trgzng1802/AC-POWER-MEASURING-STM32/Report/Source/images/thucte.jpg

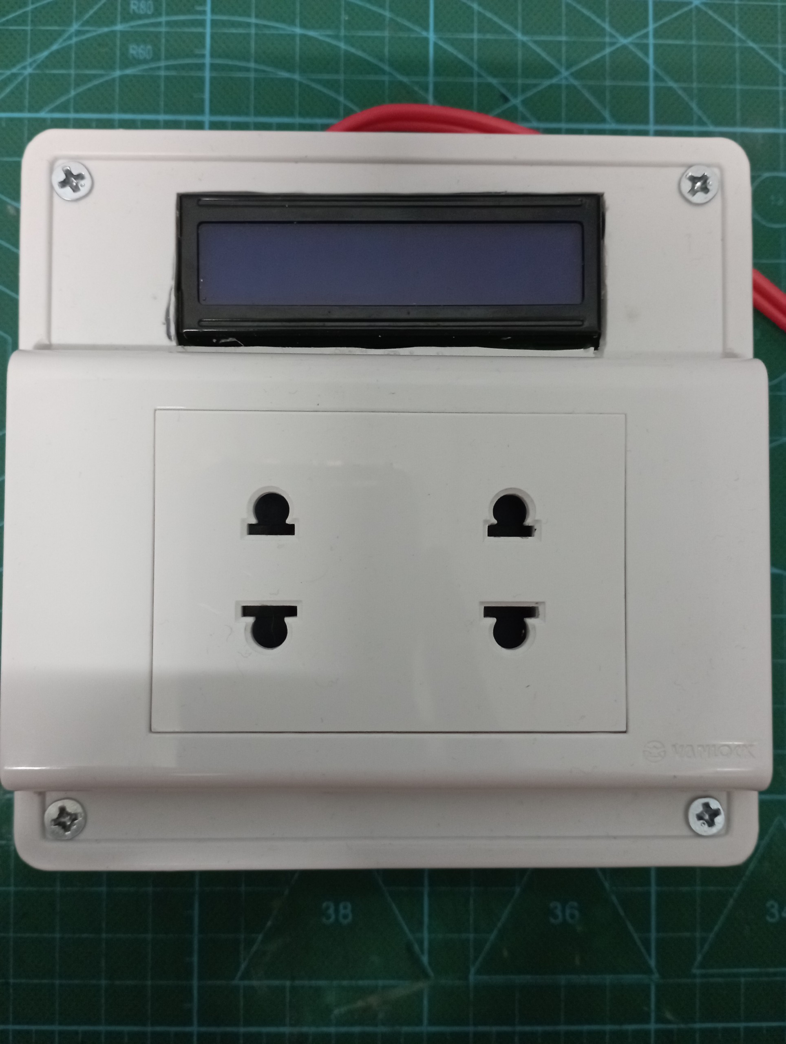
Report/Source/images/thucte.jpg
