trgzng1802/AC-POWER-MEASURING-STM32/Report/Source/images/bien_ap_thuong.jpg

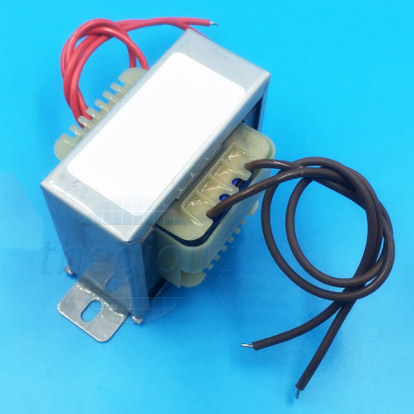
Report/Source/images/bien_ap_thuong.jpg
