trgzng1802/AC-POWER-MEASURING-STM32/SCRIPT/Power-Supplies.docx

NGUỒN CÁCH LY VÀ NGUỒN KHÔNG CÁCH LY

Nguồn cách ly

Nguồn cách ly là nguồn cách ly về điện với phần mà nó đang cấp nguồn, thường là bởi biến áp cách ly. Đồng nghĩa với việc nguồn điện được truyền từ đầu vào đến đầu ra mà không cần kết nối trực tiếp giữa 2 phần.
