trgzng1802/AC-POWER-MEASURING-STM32/Report/Source/images/adc_scan_continuous.png

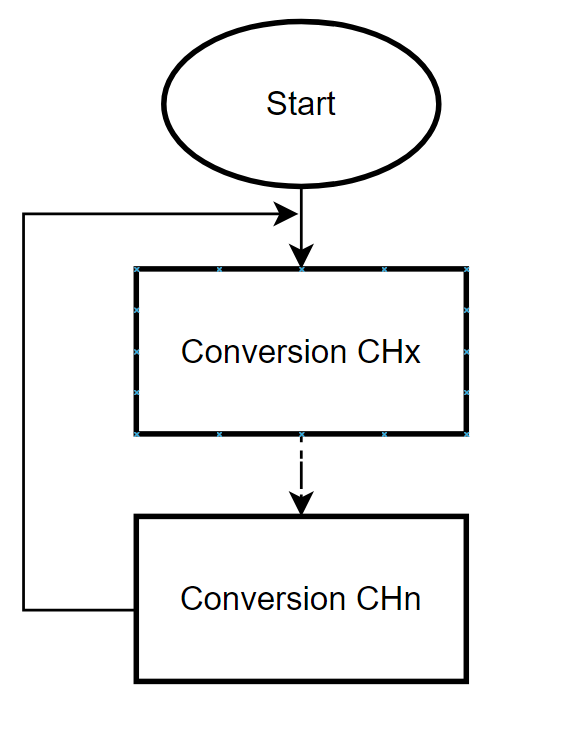
Report/Source/images/adc_scan_continuous.png
