trgzng1802/AC-POWER-MEASURING-STM32/Report/Source/images/adc_scan_single_mode.png

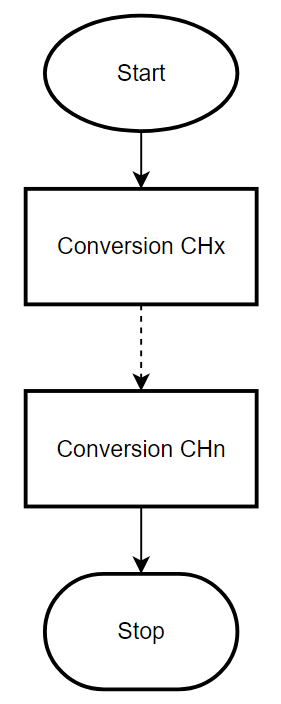
Report/Source/images/adc_scan_single_mode.png
