trgzng1802/AC-POWER-MEASURING-STM32/Report/Source/images/adc_single_single_conv.png

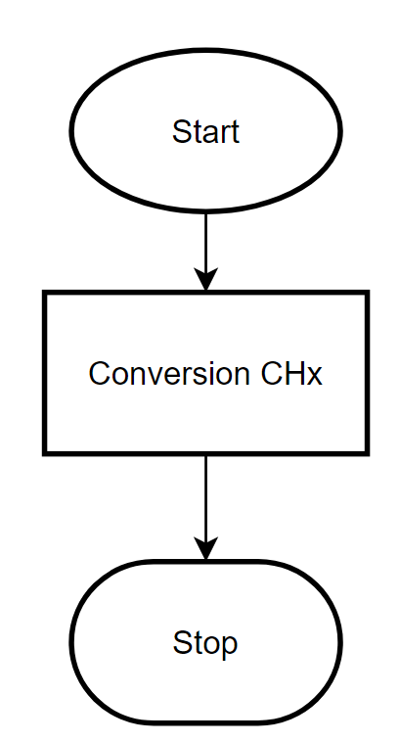
Report/Source/images/adc_single_single_conv.png
