trgzng1802/AC-POWER-MEASURING-STM32/Report/Source/images/clock_tree.png

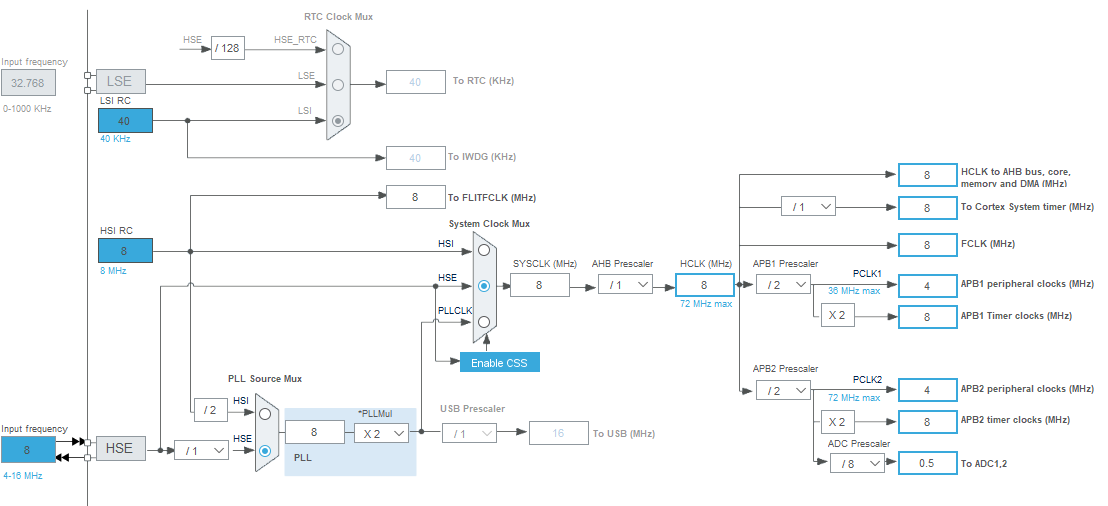
Report/Source/images/clock_tree.png
