trgzng1802/AC-POWER-MEASURING-STM32/Report/Source/images/config_adc.png

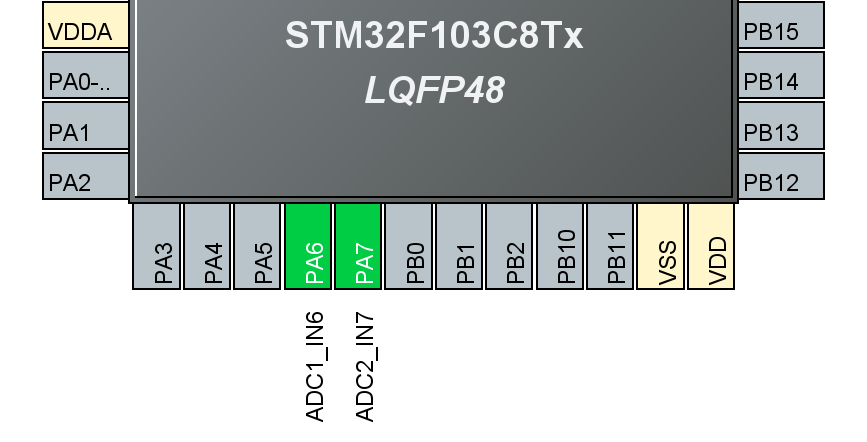
Report/Source/images/config_adc.png
