trgzng1802/AC-POWER-MEASURING-STM32/Report/Source/images/current_meas.png

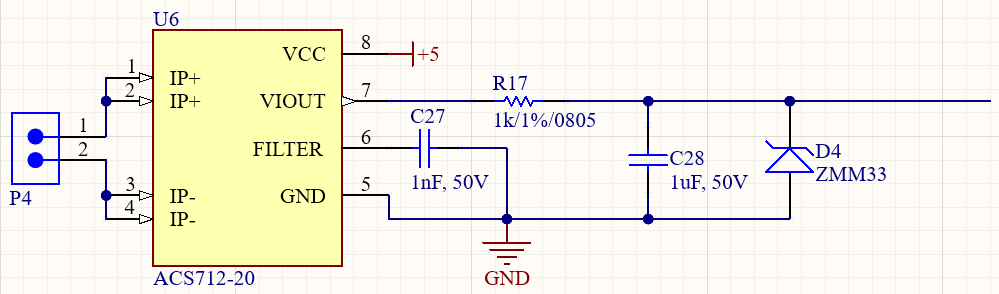
Report/Source/images/current_meas.png
