trgzng1802/AC-POWER-MEASURING-STM32/Report/Source/images/LDO_3.3.png

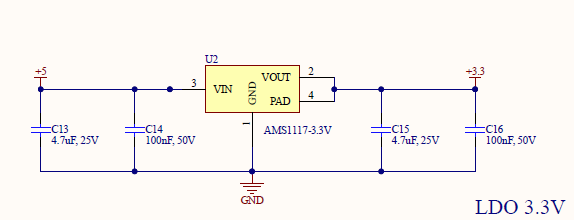
Report/Source/images/LDO_3.3.png
