trgzng1802/AC-POWER-MEASURING-STM32/Report/Source/images/LDO_5.png

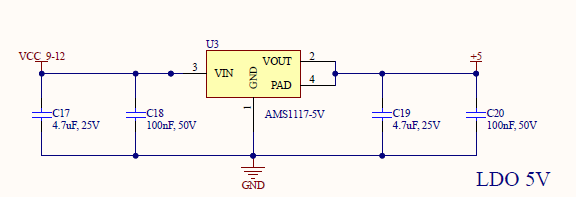
Report/Source/images/LDO_5.png
