trgzng1802/AC-POWER-MEASURING-STM32/Report/Source/images/opamp_diff_g20.png

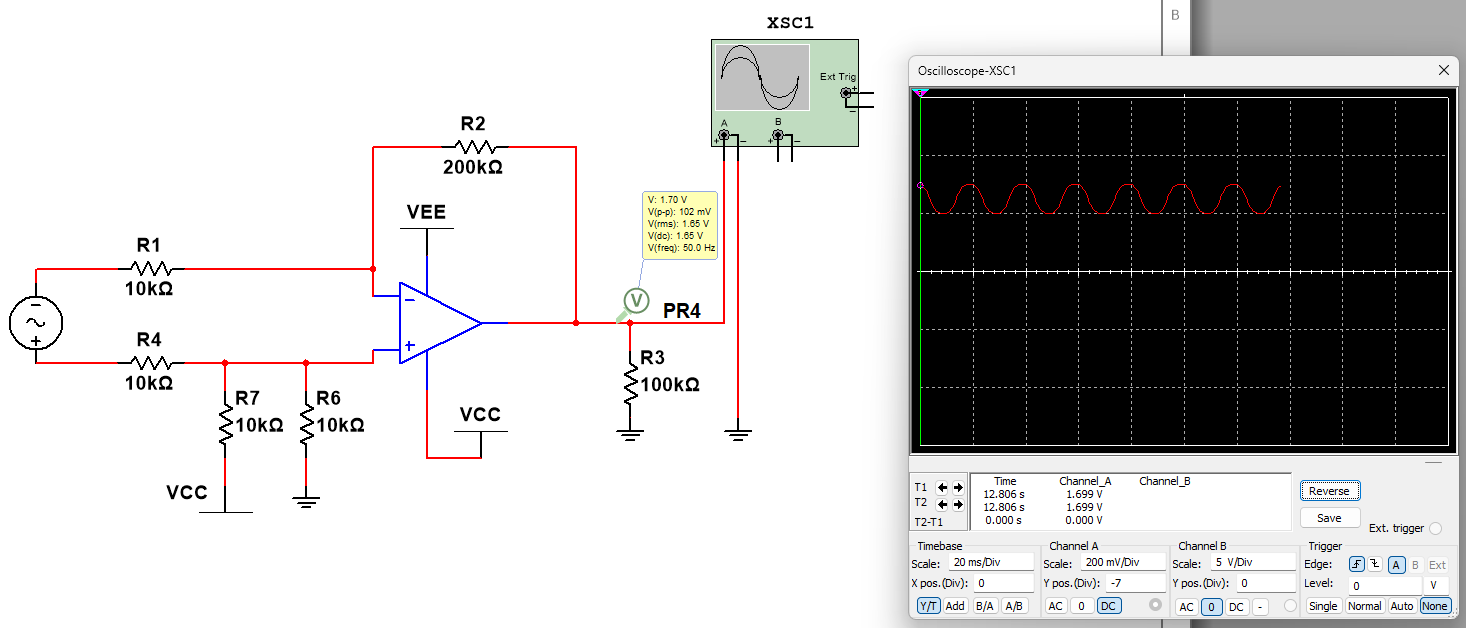
Report/Source/images/opamp_diff_g20.png
