trgzng1802/AC-POWER-MEASURING-STM32/Report/Source/images/opamp_differ.png

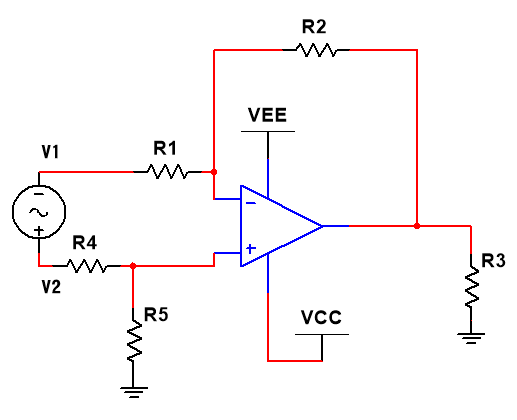
Report/Source/images/opamp_differ.png
