trgzng1802/AC-POWER-MEASURING-STM32/Report/Source/images/opamp_differ_simu.png

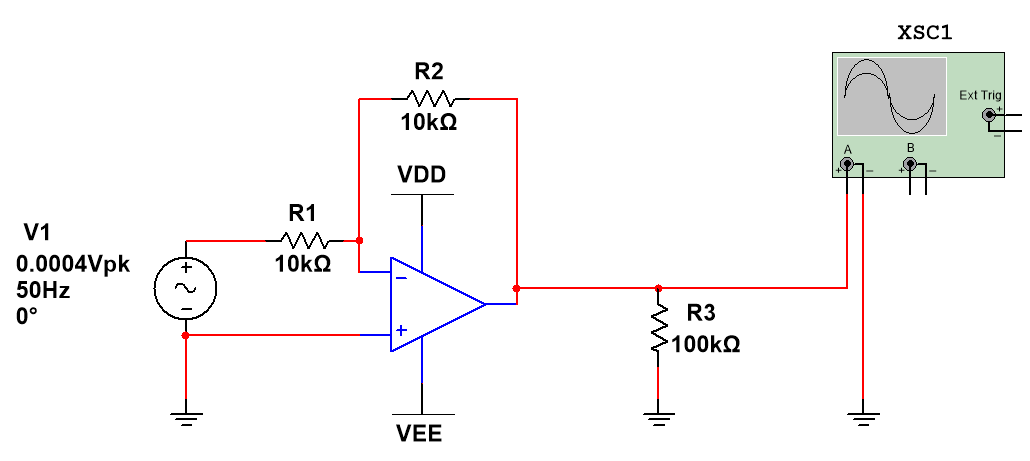
Report/Source/images/opamp_differ_simu.png
