trgzng1802/AC-POWER-MEASURING-STM32/Report/Source/images/xtal.png

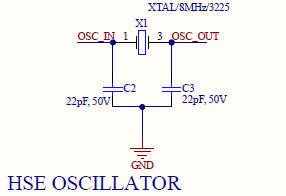
Report/Source/images/xtal.png
