trgzng1802/AC-POWER-MEASURING-STM32/SCRIPT/zmct103c_module_schematic.webp

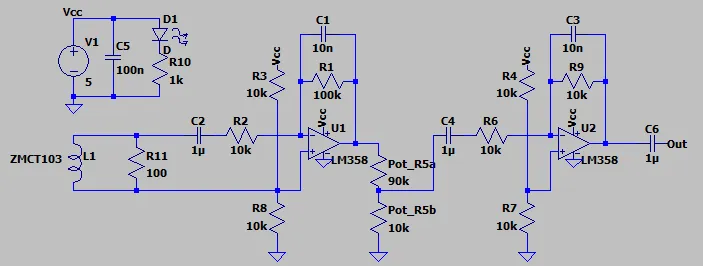
SCRIPT/zmct103c_module_schematic.webp
