trgzng1802/AC-POWER-MEASURING-STM32/HARDWARE/BOARD/AC_POWER_MEASURING/Project Outputs for AC_POWER_MEASURING/DOCs/2023-05-31_11-16_AC_POWER_MEASURING_SCHEMATICS.PDF

3 6 | 3 5
4 8 | 4 7


NEGA 2


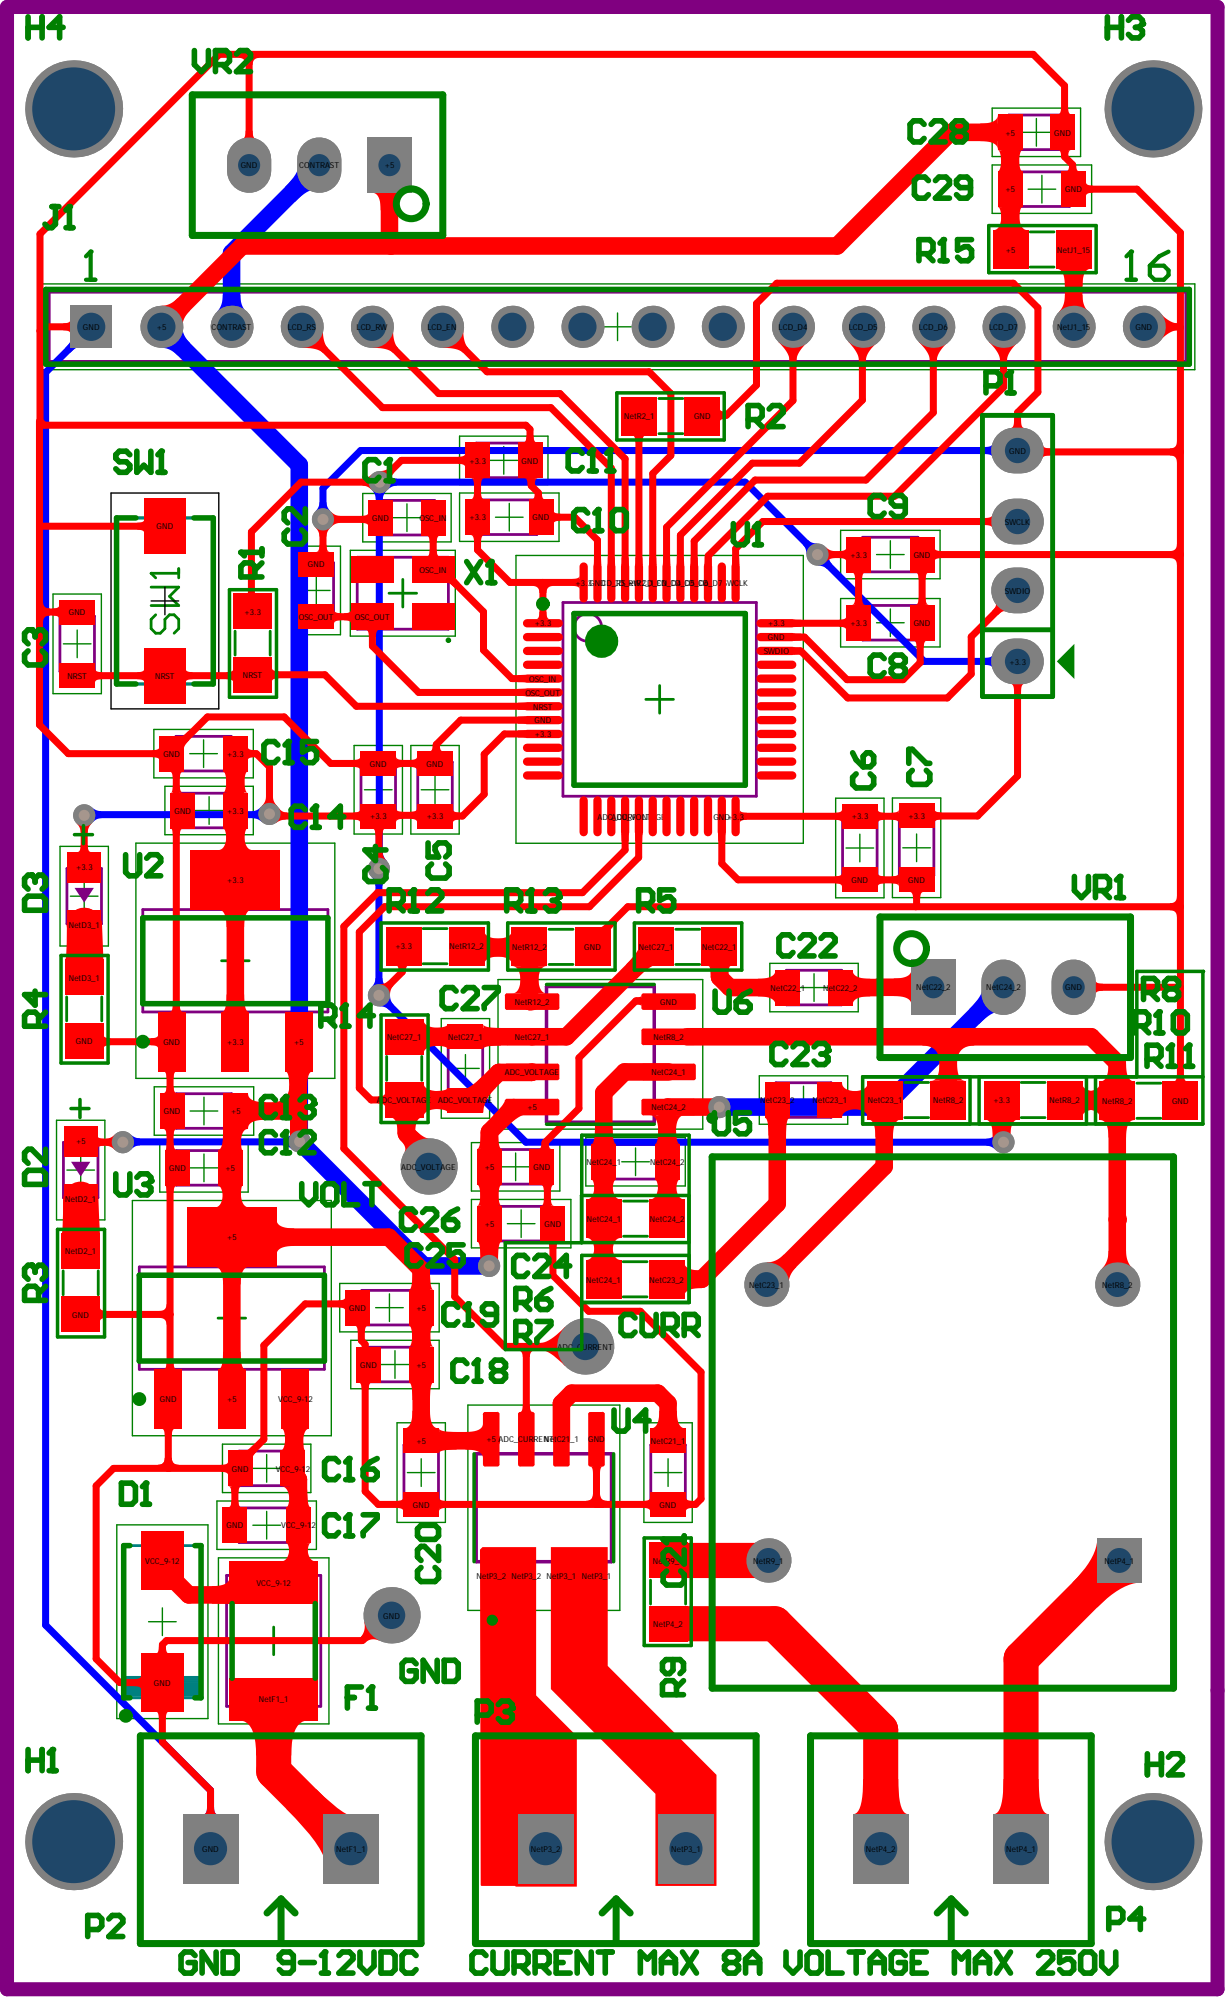
[picture p69: page 7]

NetC22_1 | NetC22_2

GND

+5 ADC_CURRENTetC21_1 GND

GND | VCC_9-12

GND | NetF1_1
