trgzng1802/AC-POWER-MEASURING-STM32/HARDWARE/BOARD/demo_1.pdf

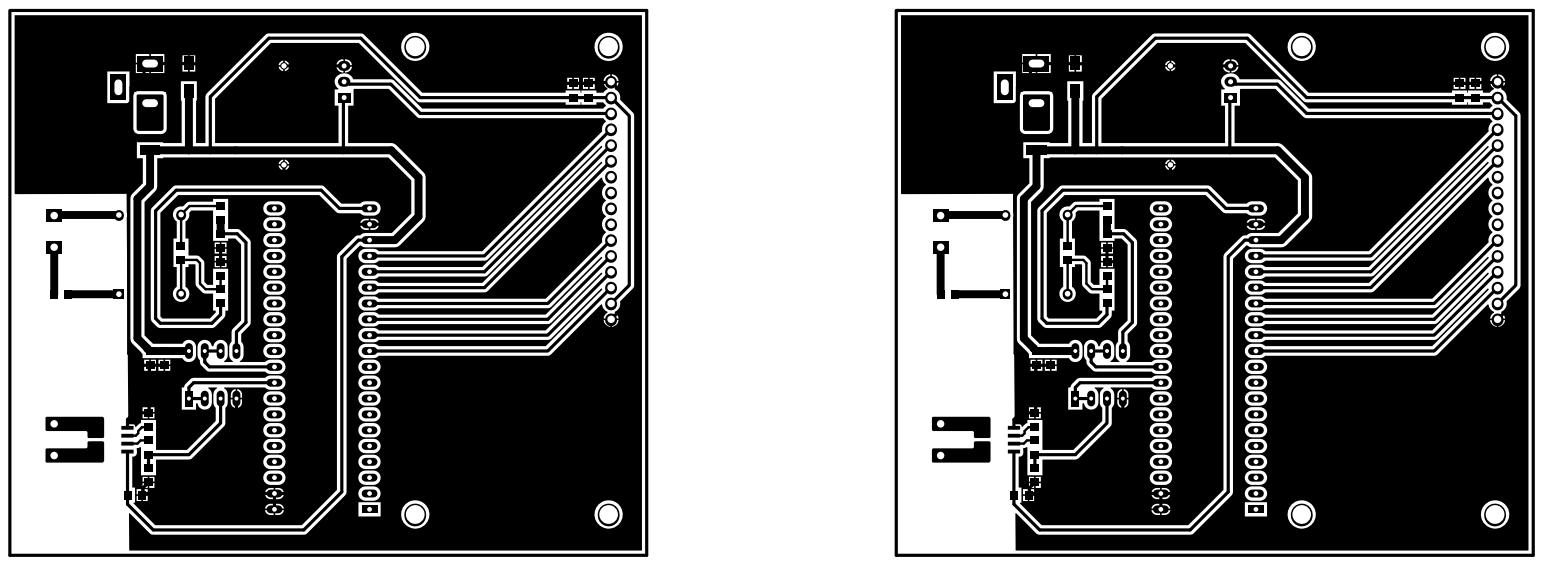
[picture p74: page 1]
