trgzng1802/AC-POWER-MEASURING-STM32/HARDWARE/BOARD/test_measure_v1.pdf

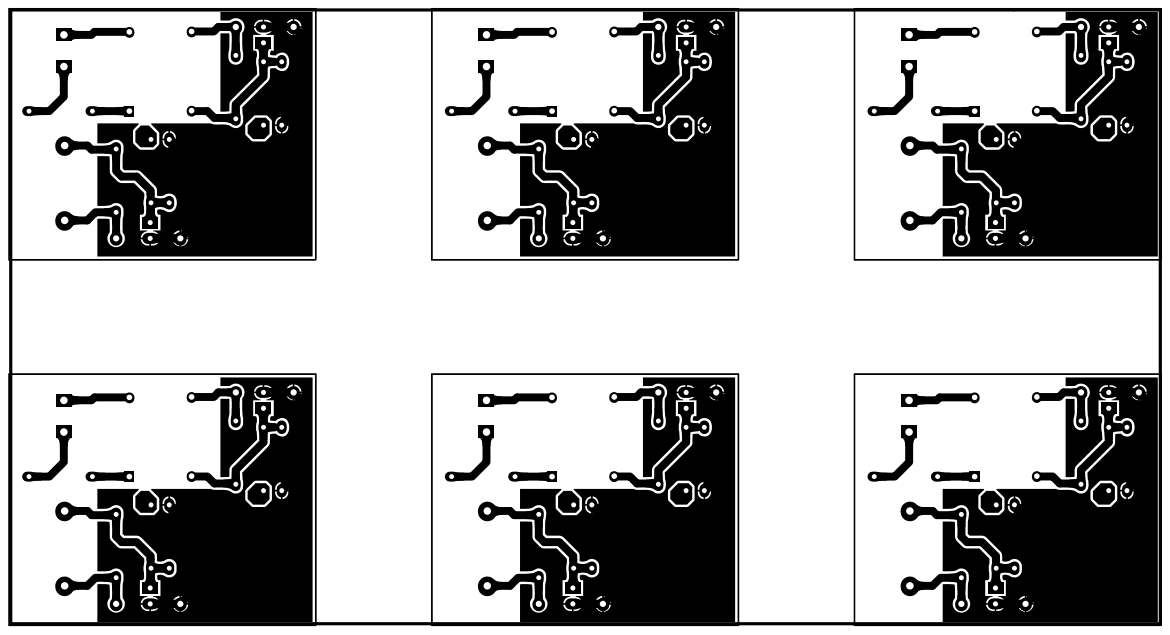
[picture p75: page 1]
