trgzng1802/AC-POWER-MEASURING-STM32/HARDWARE/BOARD/AC_POWER_MEASURING/Project Outputs for AC_POWER_MEASURING/ver1.PDF

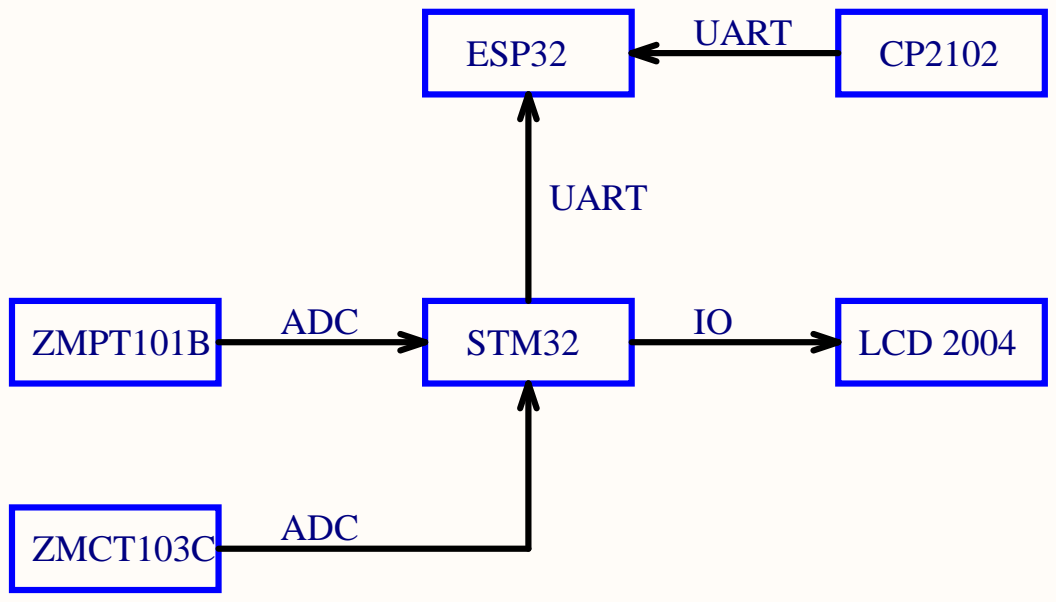
[picture p76: page 1]

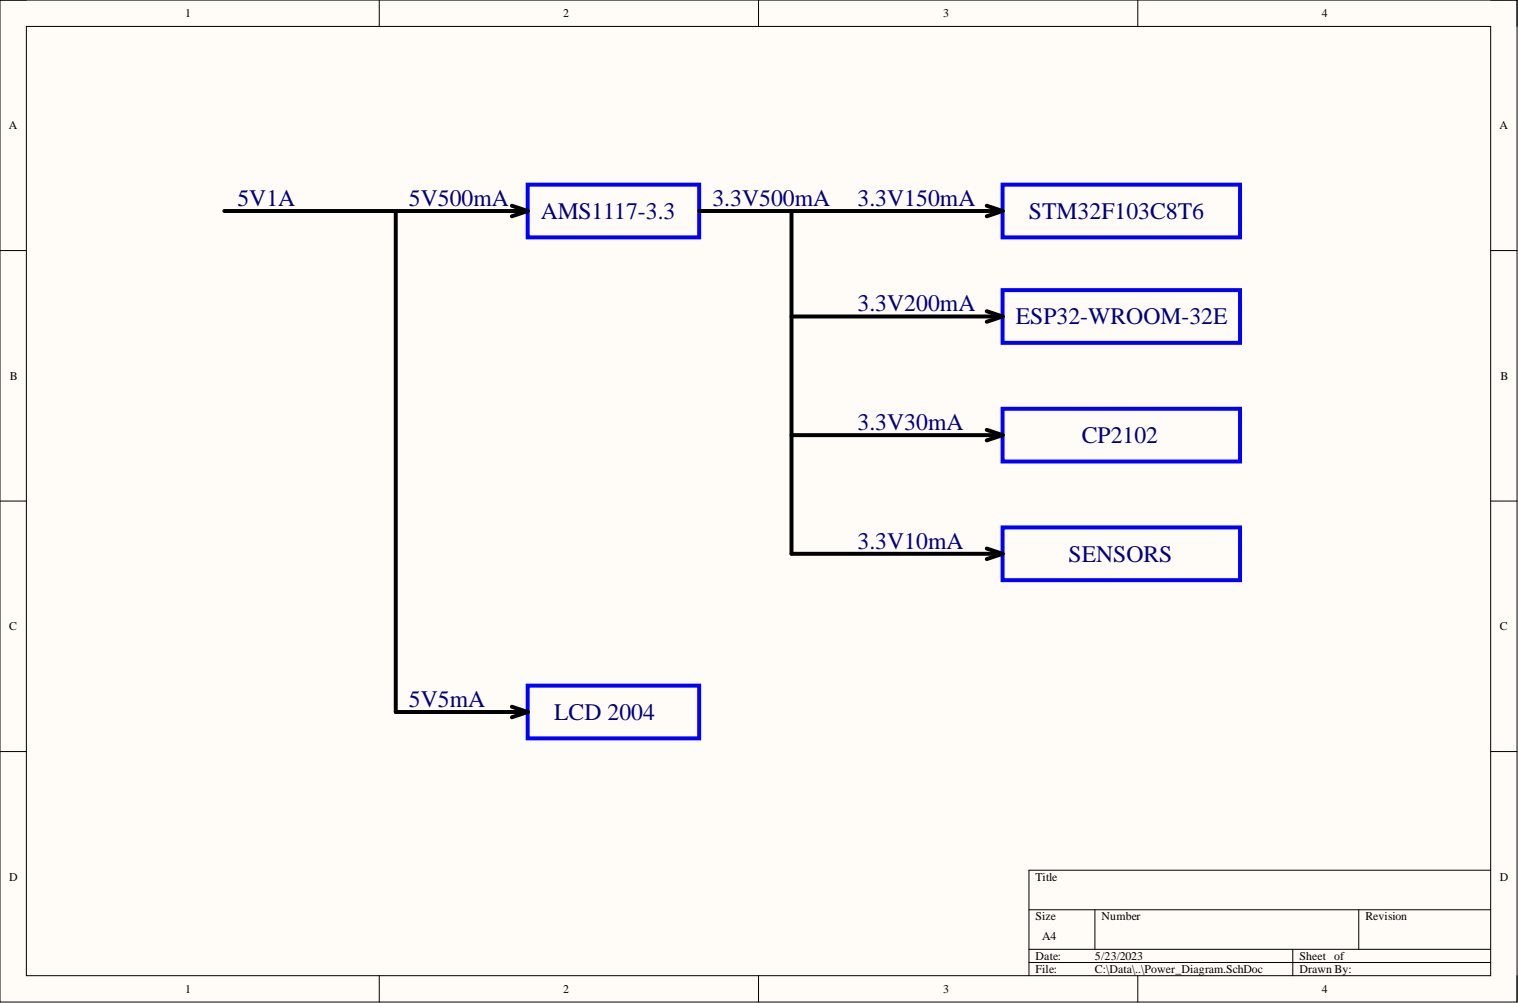
[picture p77: page 2]

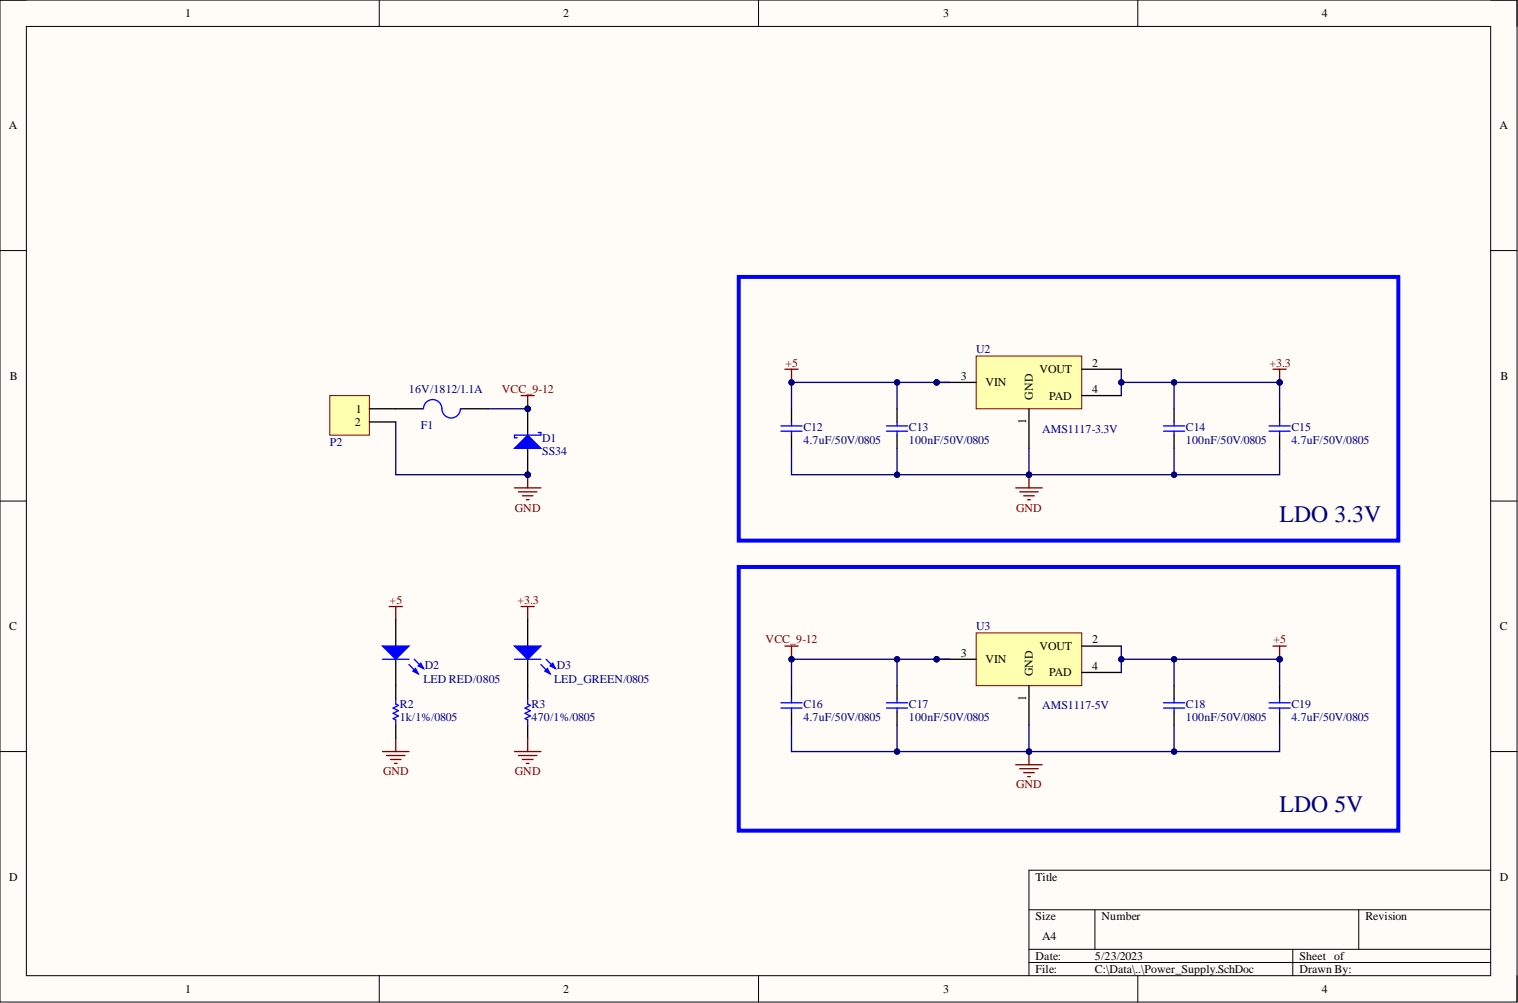
[picture p78: page 3]

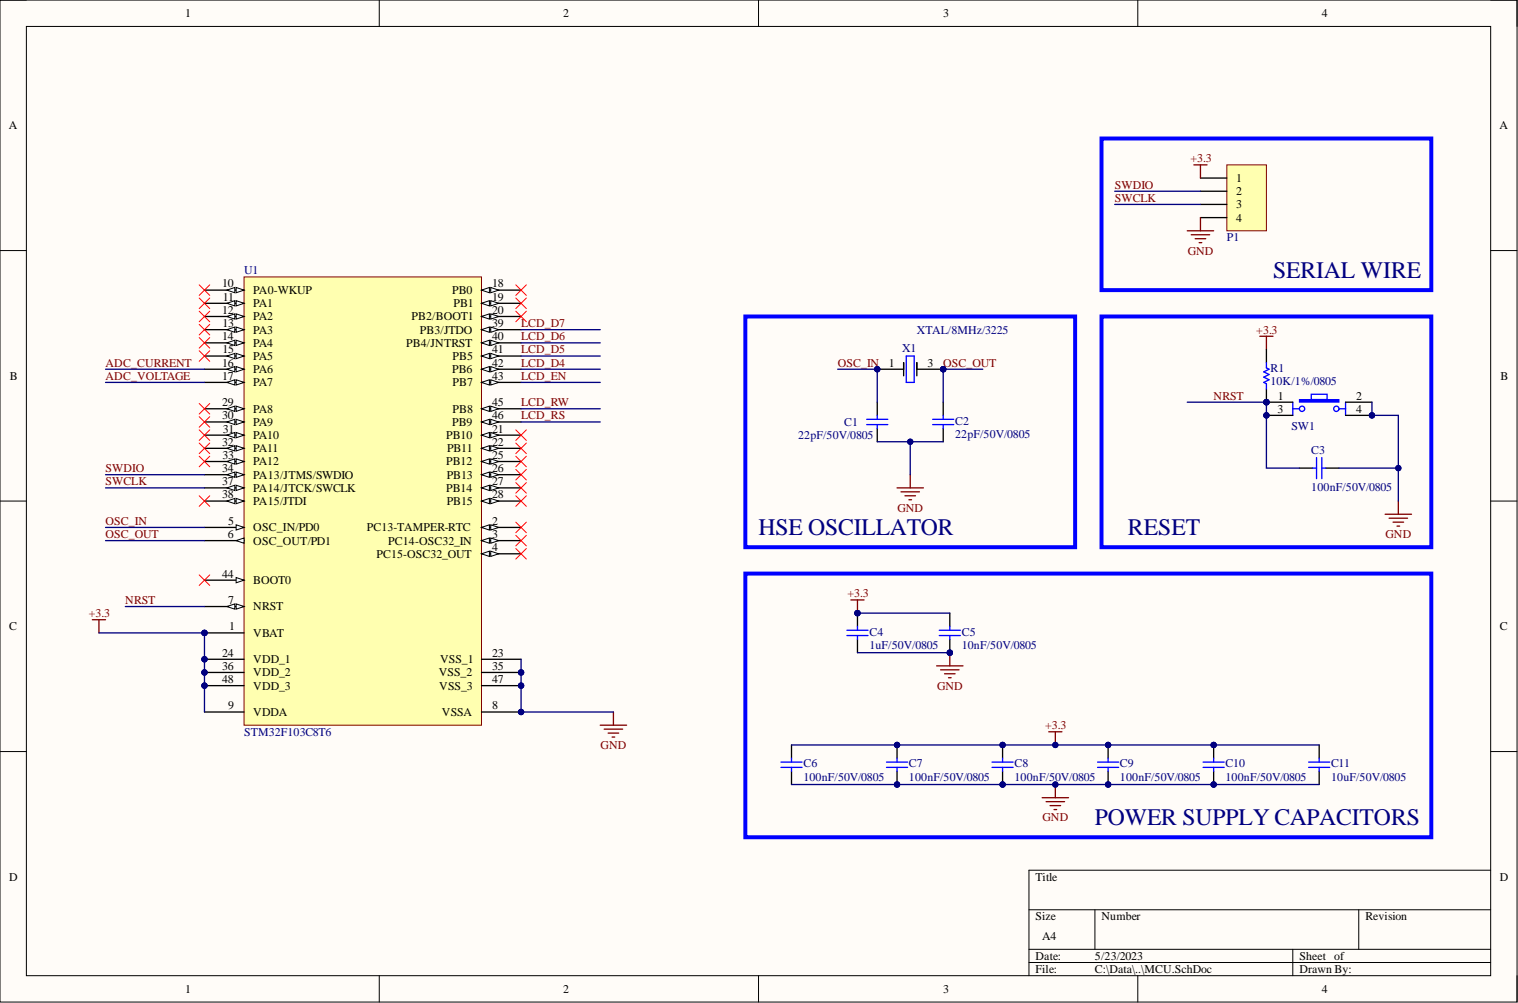
[picture p79: page 4]

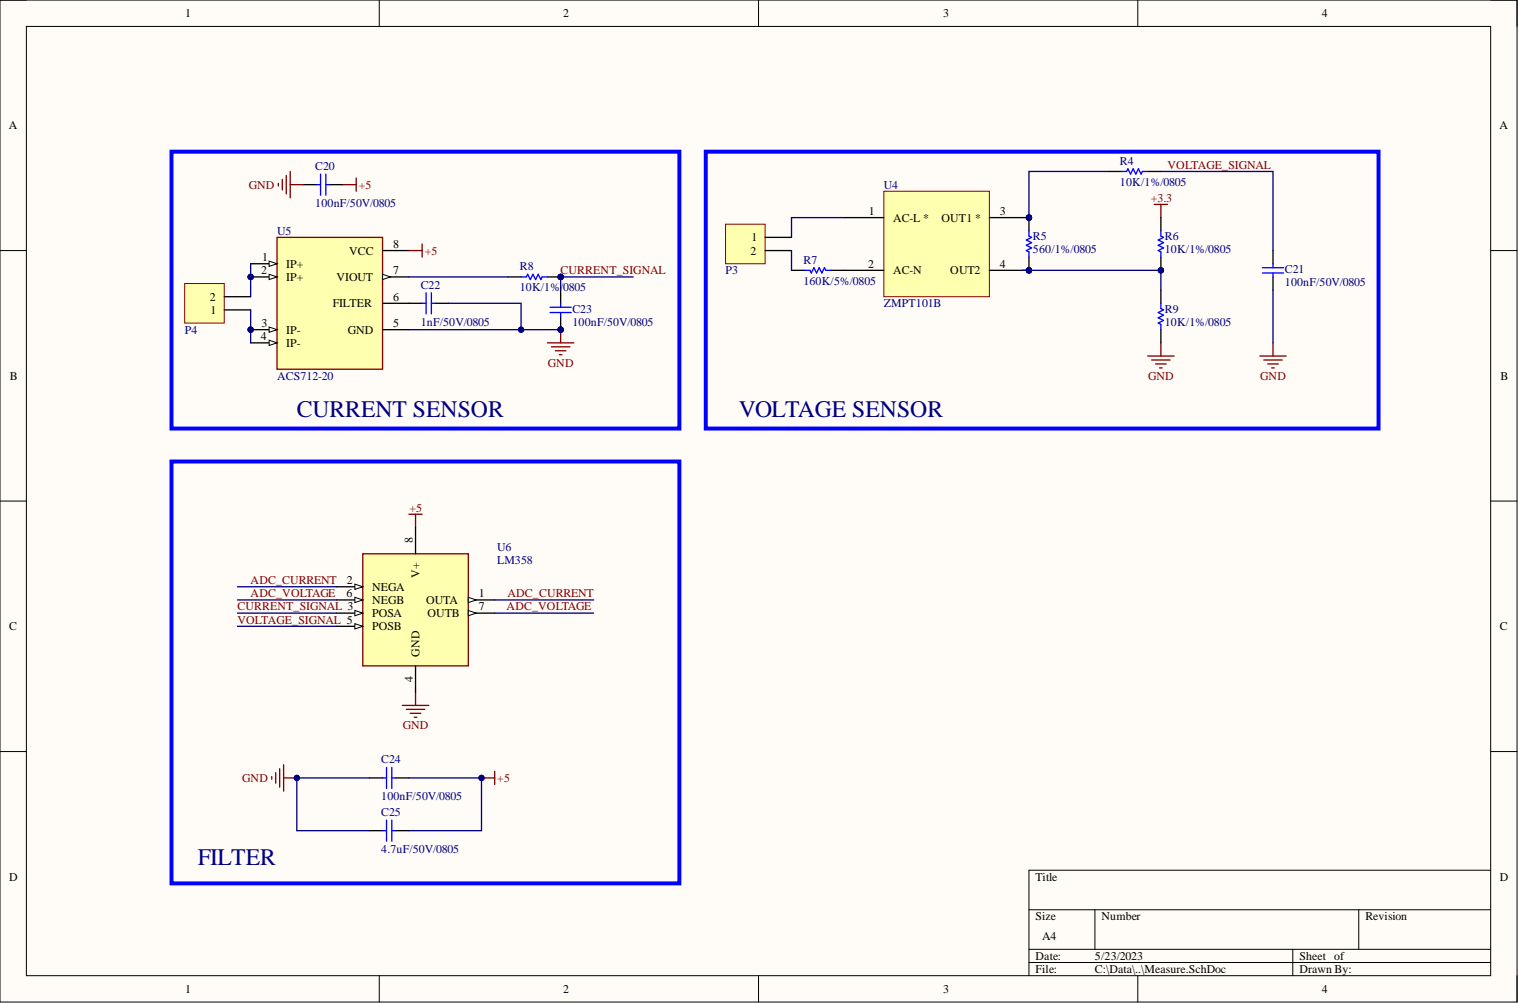
[picture p80: page 5]

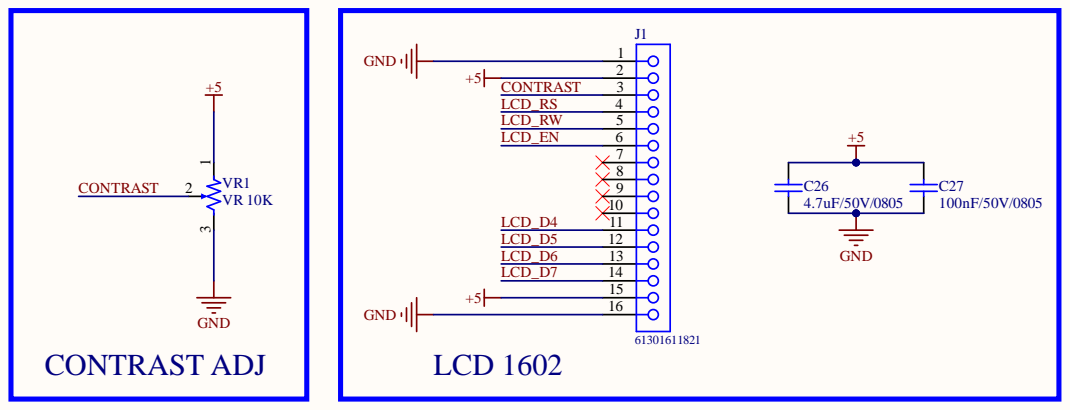
[picture p81: page 6]
