trgzng1802/AC-POWER-MEASURING-STM32/HARDWARE/BOARD/AC_POWER_MEASURING/Project Outputs for AC_POWER_MEASURING/DOCs/2023-05-24_17-29_AC_POWER_MEASURING_SCHEMATICS.PDF

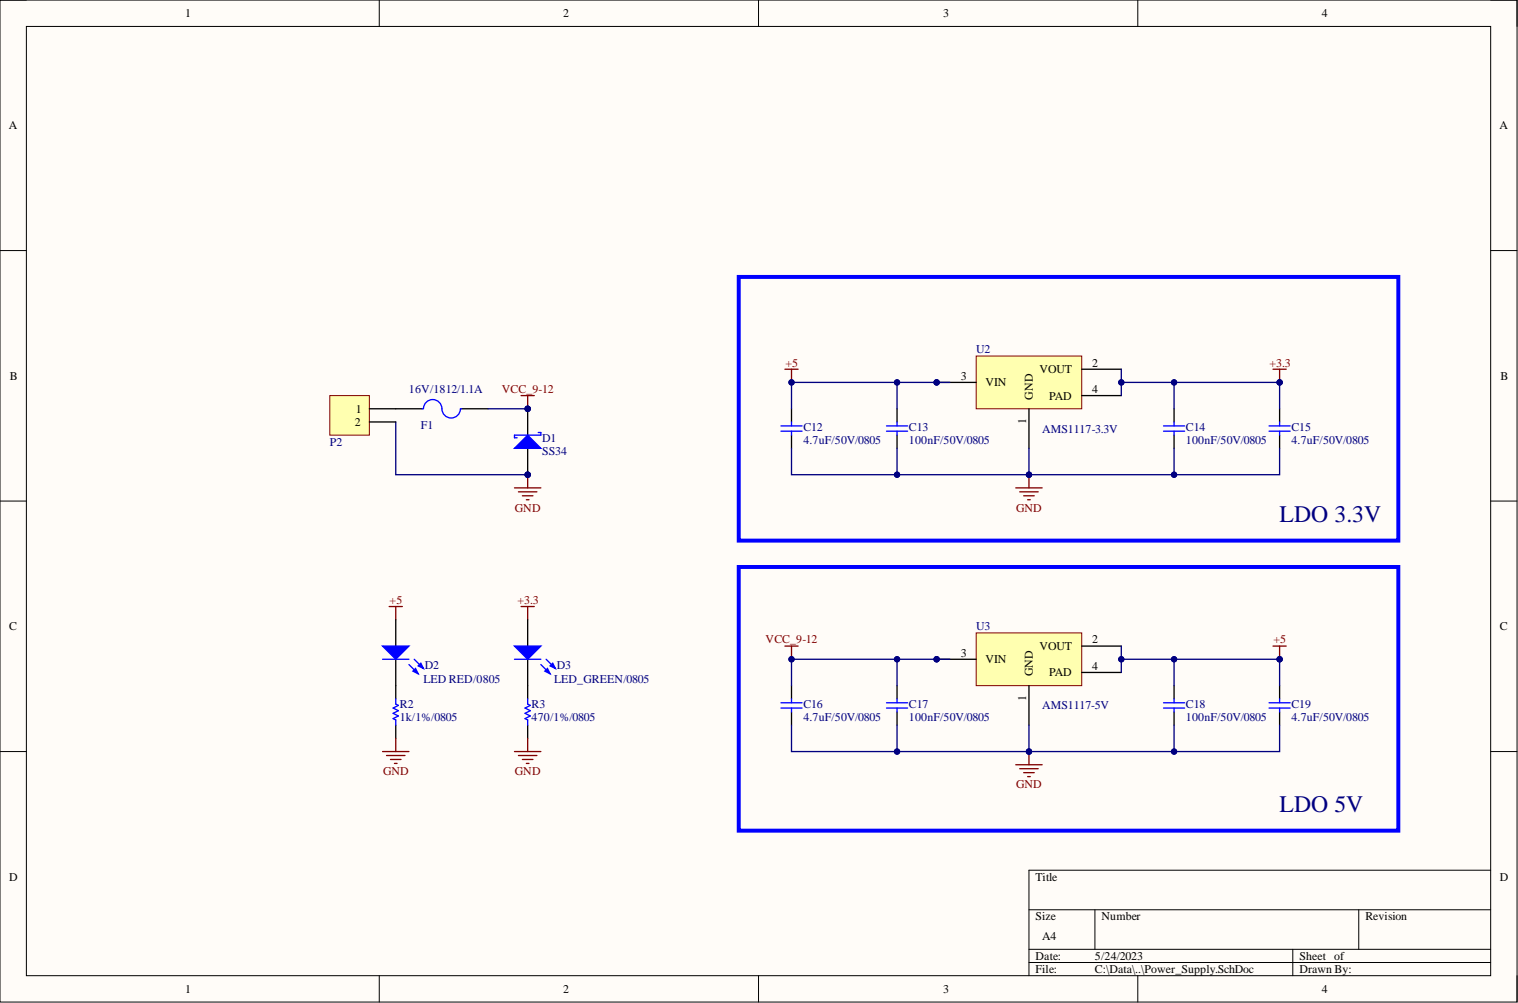
[picture p82: page 3]

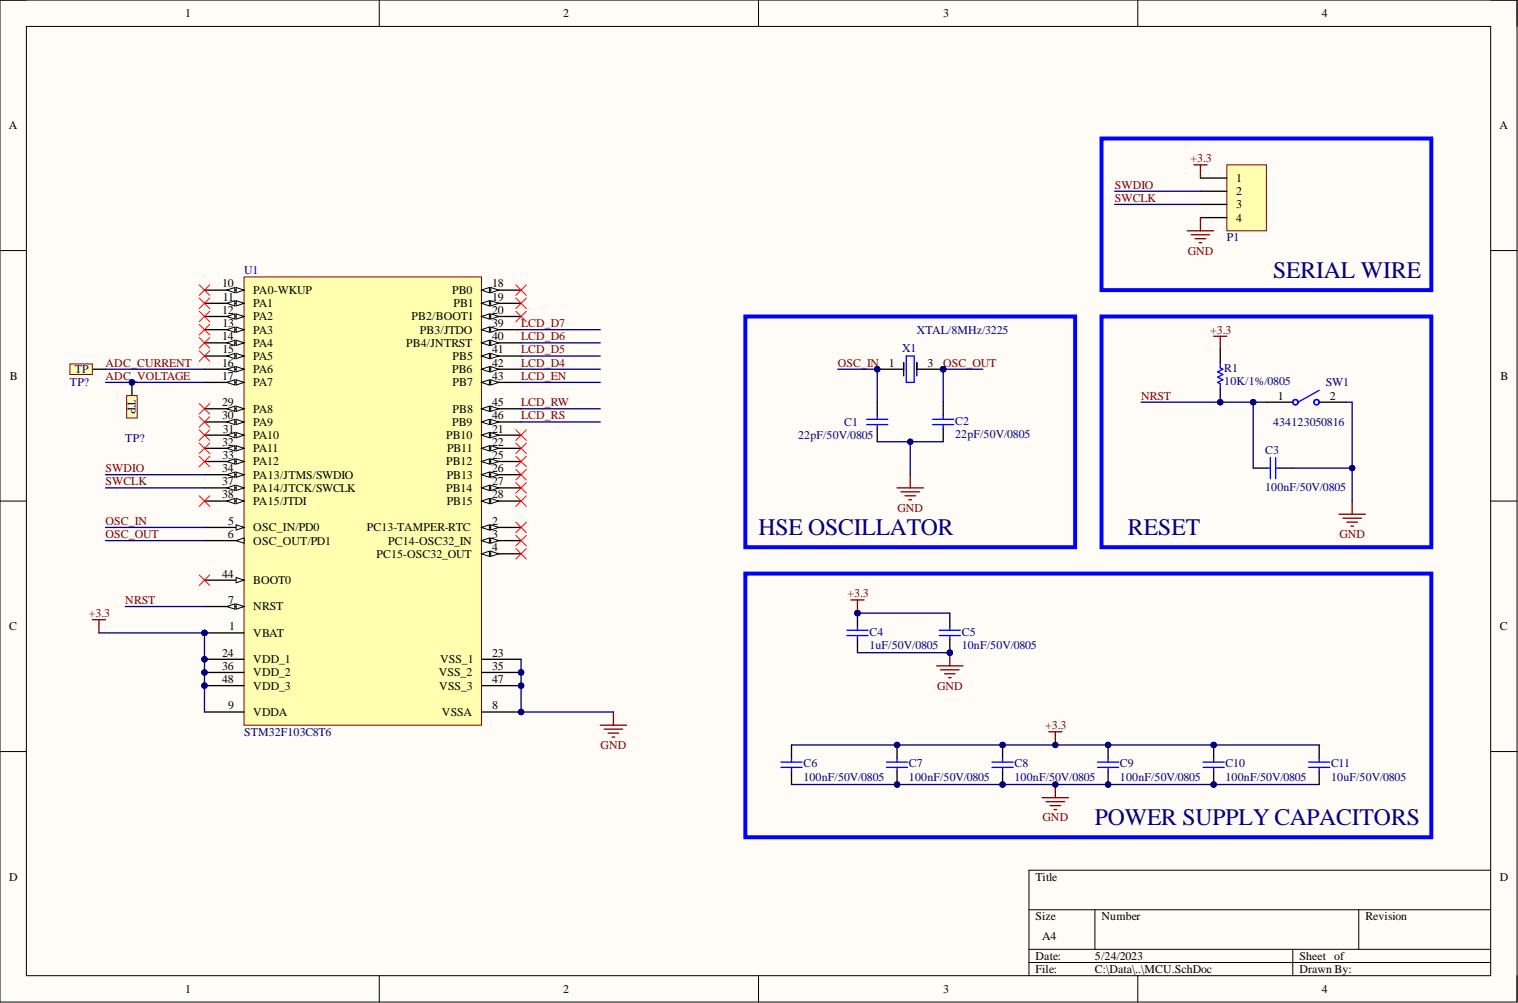
[picture p83: page 4]

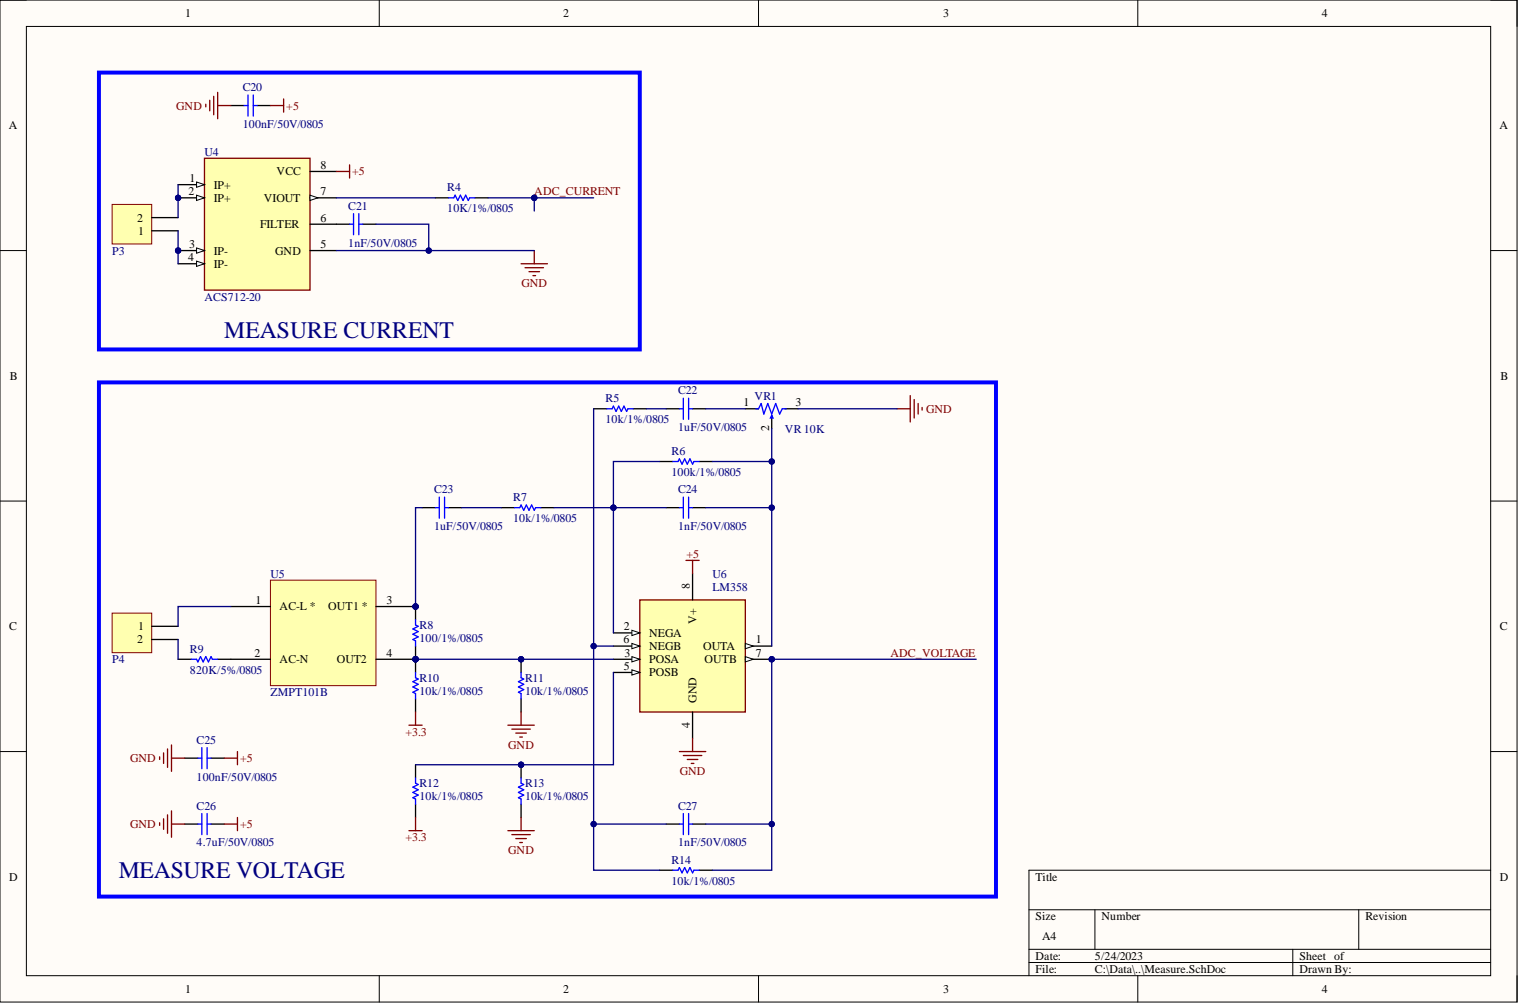
[picture p84: page 5]

NEGA 2

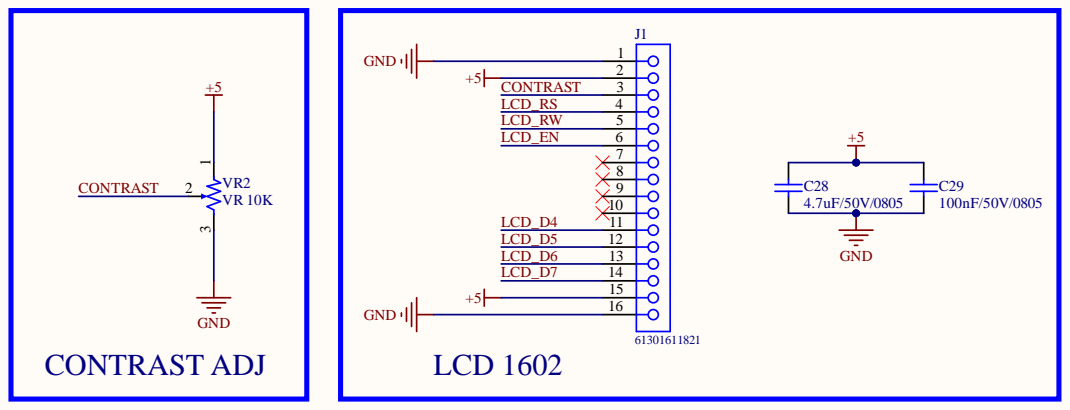
[picture p85: page 6]
