trgzng1802/AC-POWER-MEASURING-STM32/HARDWARE/BOARD/AC_POWER_MEASURING/Project Outputs for AC_POWER_MEASURING/DOCs/2023-05-24_18-31_AC_POWER_MEASURING_SCHEMATICS.PDF

3 6 | 3 5
4 8 | 4 7


NEGA 2
