trgzng1802/AC-POWER-MEASURING-STM32/(list of files, drawings)

Other design files:
HARDWARE/BOARD/AC_POWER_MEASURING/AC_POWER_MEASURING.PrjPcb
HARDWARE/BOARD/AC_POWER_MEASURING/Block_Diagram.SchDoc
HARDWARE/BOARD/AC_POWER_MEASURING/Bluepill.SchDoc
HARDWARE/BOARD/AC_POWER_MEASURING/demo_1.PcbDoc
HARDWARE/BOARD/AC_POWER_MEASURING/Display.SchDoc
HARDWARE/BOARD/AC_POWER_MEASURING/ESP32.SchDoc
HARDWARE/BOARD/AC_POWER_MEASURING/MCU.SchDoc
HARDWARE/BOARD/AC_POWER_MEASURING/Measure.SchDoc
HARDWARE/BOARD/AC_POWER_MEASURING/multi_test_measure.PcbDoc
HARDWARE/BOARD/AC_POWER_MEASURING/Power_Diagram.SchDoc
HARDWARE/BOARD/AC_POWER_MEASURING/Power_Supply.SchDoc
HARDWARE/BOARD/AC_POWER_MEASURING/test_measure.PcbDoc
HARDWARE/BOARD/AC_POWER_MEASURING/UART_Interface.SchDoc
HARDWARE/BOARD/AC_POWER_MEASURING/ver1.PcbDoc
HARDWARE/BOARD/AC_POWER_MEASURING/ver2.PcbDoc
HARDWARE/BOARD/AC_POWER_MEASURING/ver3.PcbDoc
HARDWARE/SIMULATE/ac_power_measuring.pdsprj
HARDWARE/SIMULATE/Project Backups/ac_power_measuring [20230402, 15-42-55].pdsprj
HARDWARE/SIMULATE/Project Backups/ac_power_measuring [20230408, 17-42-06].pdsprj
HARDWARE/SIMULATE/Project Backups/ac_power_measuring [20230408, 18-05-37].pdsprj
HARDWARE/SIMULATE/Project Backups/ac_power_measuring [20230411, 19-16-14].pdsprj
HARDWARE/SIMULATE/Project Backups/ac_power_measuring [20230419, 21-59-06].pdsprj
HARDWARE/SIMULATE/Project Backups/ac_power_measuring [20230421, 20-49-47].pdsprj
HARDWARE/SIMULATE/Project Backups/ac_power_measuring [20230519, 16-32-15].pdsprj
HARDWARE/SIMULATE/Project Backups/ac_power_measuring [20230523, 23-36-08].pdsprj
HARDWARE/SIMULATE/Project Backups/ac_power_measuring [20230704, 22-31-24].pdsprj
