trgzng1802/AC-POWER-MEASURING-STM32/FIRMWARE/MEASURE-AC-VOLTAGE/Core/Src/main.c

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
/* Includes ------------------------------------------------------------------*/
#include "main.h"

/* USER CODE BEGIN Includes */
#include "LCD.h"
#include "stdio.h"
#include "math.h"
/* USER CODE END Includes */

/* USER CODE BEGIN PD */
#define VOLT_GAIN		2670
#define CURR_GAIN		84.5

#define ADC_CALC		0.000805586 //3.3 / 4096

#define VOLT_OFFSET		1.6915
#define CURR_OFFSET		2.5111

#define SAMPLE			18
#define SUM_VALUE		44
/* USER CODE END PD */

ADC_HandleTypeDef hadc1;
ADC_HandleTypeDef hadc2;
DMA_HandleTypeDef hdma_adc1;

TIM_HandleTypeDef htim2;

/* USER CODE BEGIN PV */
LCD_HandleTypeDef LCD;
LCD_GPIOTypeDef LCD_GPIO;
LCD_SizeTypeDef LCD_Size;
uint32_t adc_value[1];
uint16_t u_t;
uint16_t i_t;

uint8_t is_mili = 0;

float curr_sum = 0;
float volt_sum = 0;
float volt_avg = 0;
float curr_avg = 0;
float Vrms = 0;
float Irms = 0;
float temp_curr = 0;
float temp_volt = 0;

uint8_t sample_count = 0;
uint8_t sum_count = 0;

char lcd_msg[50] = {};
/* USER CODE END PV */

void SystemClock_Config(void);
static void MX_GPIO_Init(void);
static void MX_DMA_Init(void);
static void MX_ADC1_Init(void);
static void MX_ADC2_Init(void);
static void MX_TIM2_Init(void);
/* USER CODE BEGIN 0 */
void HAL_ADC_ConvCpltCallback(ADC_HandleTypeDef* hadc)
{
	u_t = (adc_value[0] >> 16);
	i_t = (adc_value[0] & 0x0000ffff);
//	 sample_count++;
//
//	 volt_sum += (adc_scan_value[1] * ADC_CALC - VOLT_OFFSET);
//	 curr_sum += (adc_scan_value[0] * CALC - CURR_OFFSET);
//
//	 if (sample_count == SAMPLE)
//	 {
//		 sum_count++;
//
//		 volt_sum = volt_sum / SAMPLE;
//		 curr_sum = curr_sum / SAMPLE;
//
//		 volt_avg += (volt_sum * volt_sum);
//		 curr_avg += (curr_sum * curr_sum);
//
//		 sample_count = 0;
//	 }
//	 if (sum_count == SUM_VALUE)
//	 {
//		 temp_curr = sqrt(curr_avg / SUM_VALUE);
//		 temp_volt = sqrt(volt_avg / SUM_VALUE);
//		 Vrms = (sqrt(volt_avg / SUM_VALUE)) * VOLT_GAIN;
//		 Irms = (sqrt(curr_avg / SUM_VALUE)) * CURR_GAIN;
//
//		 sum_count = 0;
//		 sample_count = 0;
//		 volt_sum = 0;
//		 volt_avg = 0;
//		 curr_sum = 0;
//		 curr_avg = 0;
//	 }
}

/* USER CODE END 0 */

/**
  * @brief  The application entry point.
  * @retval int
  */
int main(void)
{
  /* MCU Configuration--------------------------------------------------------*/

  /* Reset of all peripherals, Initializes the Flash interface and the Systick. */
  HAL_Init();

  /* Configure the system clock */
  SystemClock_Config();

  /* Initialize all configured peripherals */
  MX_GPIO_Init();
  MX_DMA_Init();
  MX_ADC1_Init();
  MX_ADC2_Init();
  MX_TIM2_Init();
  /* USER CODE BEGIN 2 */
  LCD_GPIO.LCD_RS_PIN = LCD_RS_Pin;
  LCD_GPIO.LCD_RW_PIN = LCD_RW_Pin;
  LCD_GPIO.LCD_EN_PIN = LCD_EN_Pin;
  LCD_GPIO.LCD_D4_PIN = LCD_D4_Pin;
  LCD_GPIO.LCD_D5_PIN = LCD_D5_Pin;
  LCD_GPIO.LCD_D6_PIN = LCD_D6_Pin;
  LCD_GPIO.LCD_D7_PIN = LCD_D7_Pin;

  LCD_Size.LCD_column = 16;
  LCD_Size.LCD_row    = 2;

  LCD_Init(&LCD, GPIOB, LCD_GPIO, LCD_Size);
  HAL_ADCEx_Calibration_Start(&hadc1);
  HAL_ADCEx_Calibration_Start(&hadc2);
  HAL_Delay(10);
  HAL_ADC_Start(&hadc2);
  HAL_ADCEx_MultiModeStart_DMA(&hadc1, adc_value, 1);
  /* USER CODE END 2 */

  /* Infinite loop */
  /* USER CODE BEGIN WHILE */
  while (1)
  {
    /* USER CODE END WHILE */

    /* USER CODE BEGIN 3 */

	  LCD_SetCursor(&LCD, 0, 0);
	  sprintf(lcd_msg, "Voltage: %03d.%02dV", (uint8_t)Vrms, (uint16_t)(Vrms*100) % 100);
	  LCD_SendString(&LCD, lcd_msg);
	  LCD_SetCursor(&LCD, 0, 1);
	  sprintf(lcd_msg, "Current: %01d.%04dA", (uint8_t)Irms, (uint16_t)(Irms*10000) % 10000);
	  LCD_SendString(&LCD, lcd_msg);
  }
  /* USER CODE END 3 */
}

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
