trgzng1802/AC-POWER-MEASURING-STM32/FIRMWARE/MEASURE-AC-VOLTAGE/MEASURE_AC_VOLTAGE.ioc

Mcu.UserName=STM32F103C8Tx
PA13.Signal=SYS_JTMS-SWDIO
PA14.Signal=SYS_JTCK-SWCLK
PA6.Signal=ADCx_IN6
PA7.Signal=ADCx_IN7
PB3.GPIO_Label=LCD_D7
PB3.Signal=GPIO_Output
PB4.GPIO_Label=LCD_D6
PB4.Signal=GPIO_Output
PB5.GPIO_Label=LCD_D5
PB5.Signal=GPIO_Output
PB6.GPIO_Label=LCD_D4
PB6.Signal=GPIO_Output
PB7.GPIO_Label=LCD_EN
PB7.Signal=GPIO_Output
PB8.GPIO_Label=LCD_RW
PB8.Signal=GPIO_Output
PB9.GPIO_Label=LCD_RS
PB9.Signal=GPIO_Output
PD0-OSC_IN.Signal=RCC_OSC_IN
PD1-OSC_OUT.Signal=RCC_OSC_OUT
