trgzng1802/AC-POWER-MEASURING-STM32/FIRMWARE/MEASURE-AC-VOLTAGE/Core/Inc/main.h

#define LCD_D7_Pin GPIO_PIN_3
#define LCD_D7_GPIO_Port GPIOB
#define LCD_D6_Pin GPIO_PIN_4
#define LCD_D6_GPIO_Port GPIOB
#define LCD_D5_Pin GPIO_PIN_5
#define LCD_D5_GPIO_Port GPIOB
#define LCD_D4_Pin GPIO_PIN_6
#define LCD_D4_GPIO_Port GPIOB
#define LCD_EN_Pin GPIO_PIN_7
#define LCD_EN_GPIO_Port GPIOB
#define LCD_RW_Pin GPIO_PIN_8
#define LCD_RW_GPIO_Port GPIOB
#define LCD_RS_Pin GPIO_PIN_9
#define LCD_RS_GPIO_Port GPIOB
