trgzng1802/AC-POWER-MEASURING-STM32/FIRMWARE/watt-meter.cfg

[elf]
file_path = C:/Data/Projects/AC-POWER-MEASURING-STM32/FIRMWARE/MEASURE-AC-VOLTAGE/Debug/MEASURE_AC_VOLTAGE.elf

[settings]
sample_period = 20
version = 0
max_points = 1000
max_viewport_points = 100

[var0]
name = Irms
address = 536871268
type = 7
color = 902984554

[var1]
name = Vrms
address = 536871264
type = 7
color = 4068236418

[var2]
name = curr_avg
address = 536871224
type = 7
color = 11353684

[var3]
name = curr_sum
address = 536871212
type = 7
color = 294114306

[var4]
name = i_t
address = 536871262
type = 5
color = 1014094455

[var5]
name = temp_curr
address = 536871236
type = 7
color = 3809944546

[var6]
name = temp_volt
address = 536871240
type = 7
color = 3495552305

[var7]
name = u_t
address = 536871260
type = 5
color = 1471228449

[var8]
name = volt_avg
address = 536871220
type = 7
color = 2823662805

[var9]
name = volt_sum
address = 536871216
type = 7
color = 3507898400

[plot0]
name = current
visibility = true
type = 0

[plot0-series0]
name = Irms
visibility = false
format = DEC

[plot0-series1]
name = curr_avg
visibility = false
format = DEC

[plot0-series2]
name = curr_sum
visibility = false
format = DEC

[plot0-series3]
name = i_t
visibility = true
format = DEC

[plot0-series4]
name = temp_curr
visibility = false
format = DEC

[plot1]
name = volt
visibility = true
type = 0

[plot1-series0]
name = Vrms
visibility = false
format = DEC

[plot1-series1]
name = temp_volt
visibility = false
format = DEC

[plot1-series2]
name = u_t
visibility = true
format = DEC

[plot1-series3]
name = volt_avg
visibility = false
format = DEC

[plot1-series4]
name = volt_sum
visibility = false
format = DEC
