trgzng1802/AC-POWER-MEASURING-STM32/(commit log)

2023-04-17 done v1
    [AC_POWER_MEASURING.PrjPcb, Block_Diagram.SchDoc, Display.SchDoc, MCU.SchDoc, Measure.SchDoc, Power_Supply.SchDoc, ac_power_measuring [20230408, 17-42-06].pdsprj, ac_power_measuring [20230408, 18-05-37].pdsprj]
2023-05-24 update ver3
    [AC_POWER_MEASURING.PrjPcb, AC_POWER_MEASURING_BILL-OF-MATERIALS.xlsx, Bill of Materials-AC_POWER_MEASURING.xlsx, Block_Diagram.SchDoc, Display.SchDoc, MCU.SchDoc, Measure.SchDoc, Power_Diagram.SchDoc]
2023-06-12 ver 2.1
    [Display.SchDoc, MCU.SchDoc, Measure.SchDoc, Power_Supply.SchDoc, ver2.PcbDoc]
2023-07-05 update ver3 + report
    [AC_POWER_MEASURING.PrjPcb, Display.SchDoc, EEPROM.SchDoc, MCU.SchDoc, Measure.SchDoc, Power_Supply.SchDoc, ac_power_measuring [20230704, 22-31-24].pdsprj, ac_power_measuring.pdsprj]
2023-07-10 update 9/7
    [watt-meter.cfg]
2023-08-04 update many
    [AC_POWER_MEASURING.PrjPcb, Block_Diagram.SchDoc, Display.SchDoc, EEPROM.SchDoc, MCU.SchDoc, Measure.SchDoc, Power_Diagram.SchDoc, Power_Supply.SchDoc]
