trgzng1802/AC-POWER-MEASURING-STM32/(notices)

Notices in the files:
FIRMWARE/MEASURE-AC-VOLTAGE/Core/Src/main.c:
Copyright (c) 2023 STMicroelectronics.
All rights reserved.
This software is licensed under terms that can be found in the LICENSE file
